ecohouse/monitor-wizard-hardware/README.md

# monitor-wizard-hardware
Schematic and board layout for the Monitor Wizard hardware.
