ecohouse/monitor-wizard-hardware/MonitorWizard-Logger.brd

## EAGLE design MonitorWizard-Logger.brd (2015-12-05)

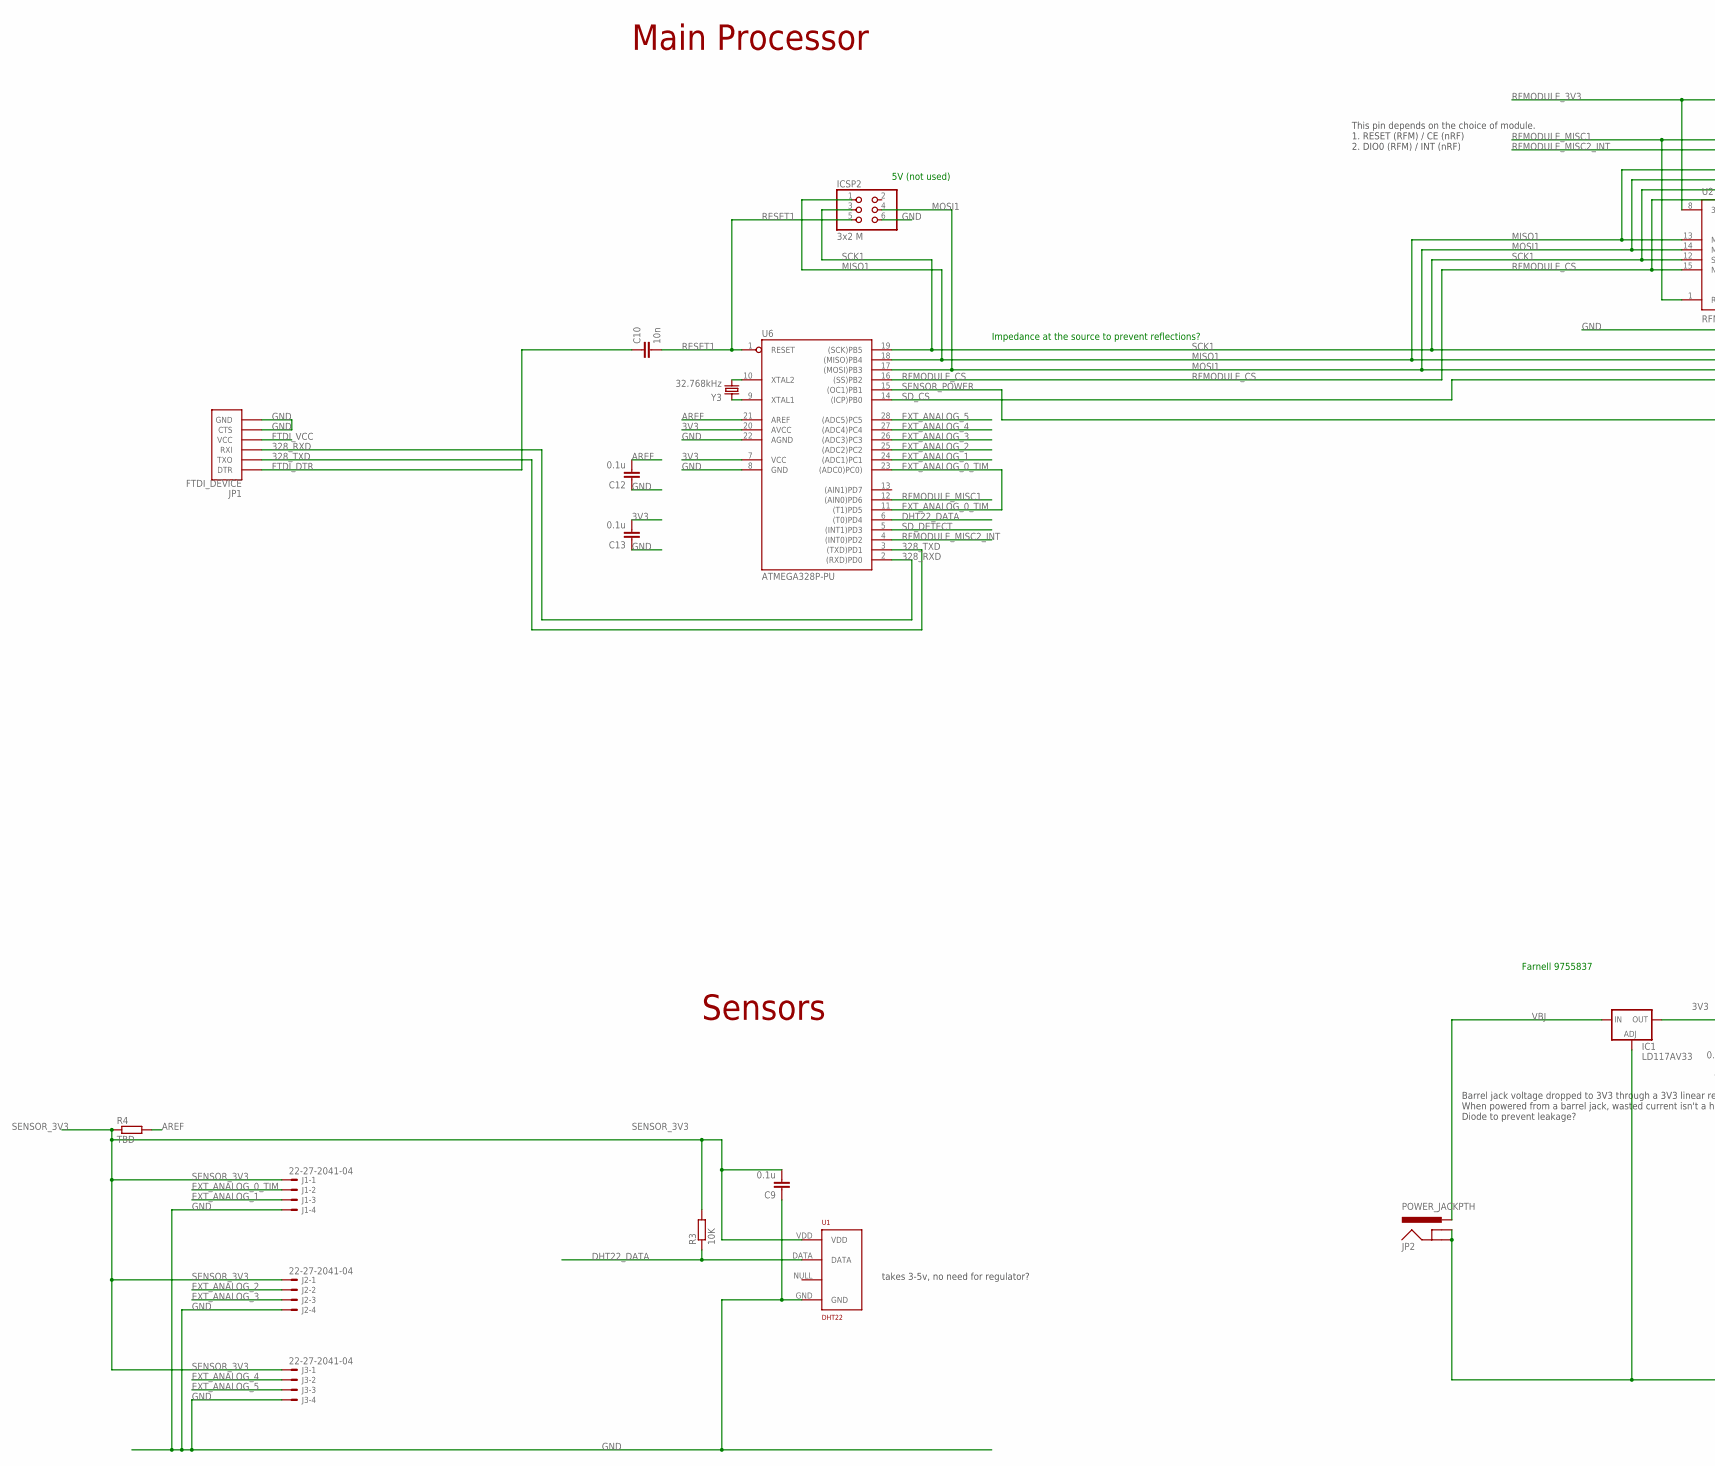
[picture p1: schematic MonitorWizard-Logger.sch, part in row 1, column 1]

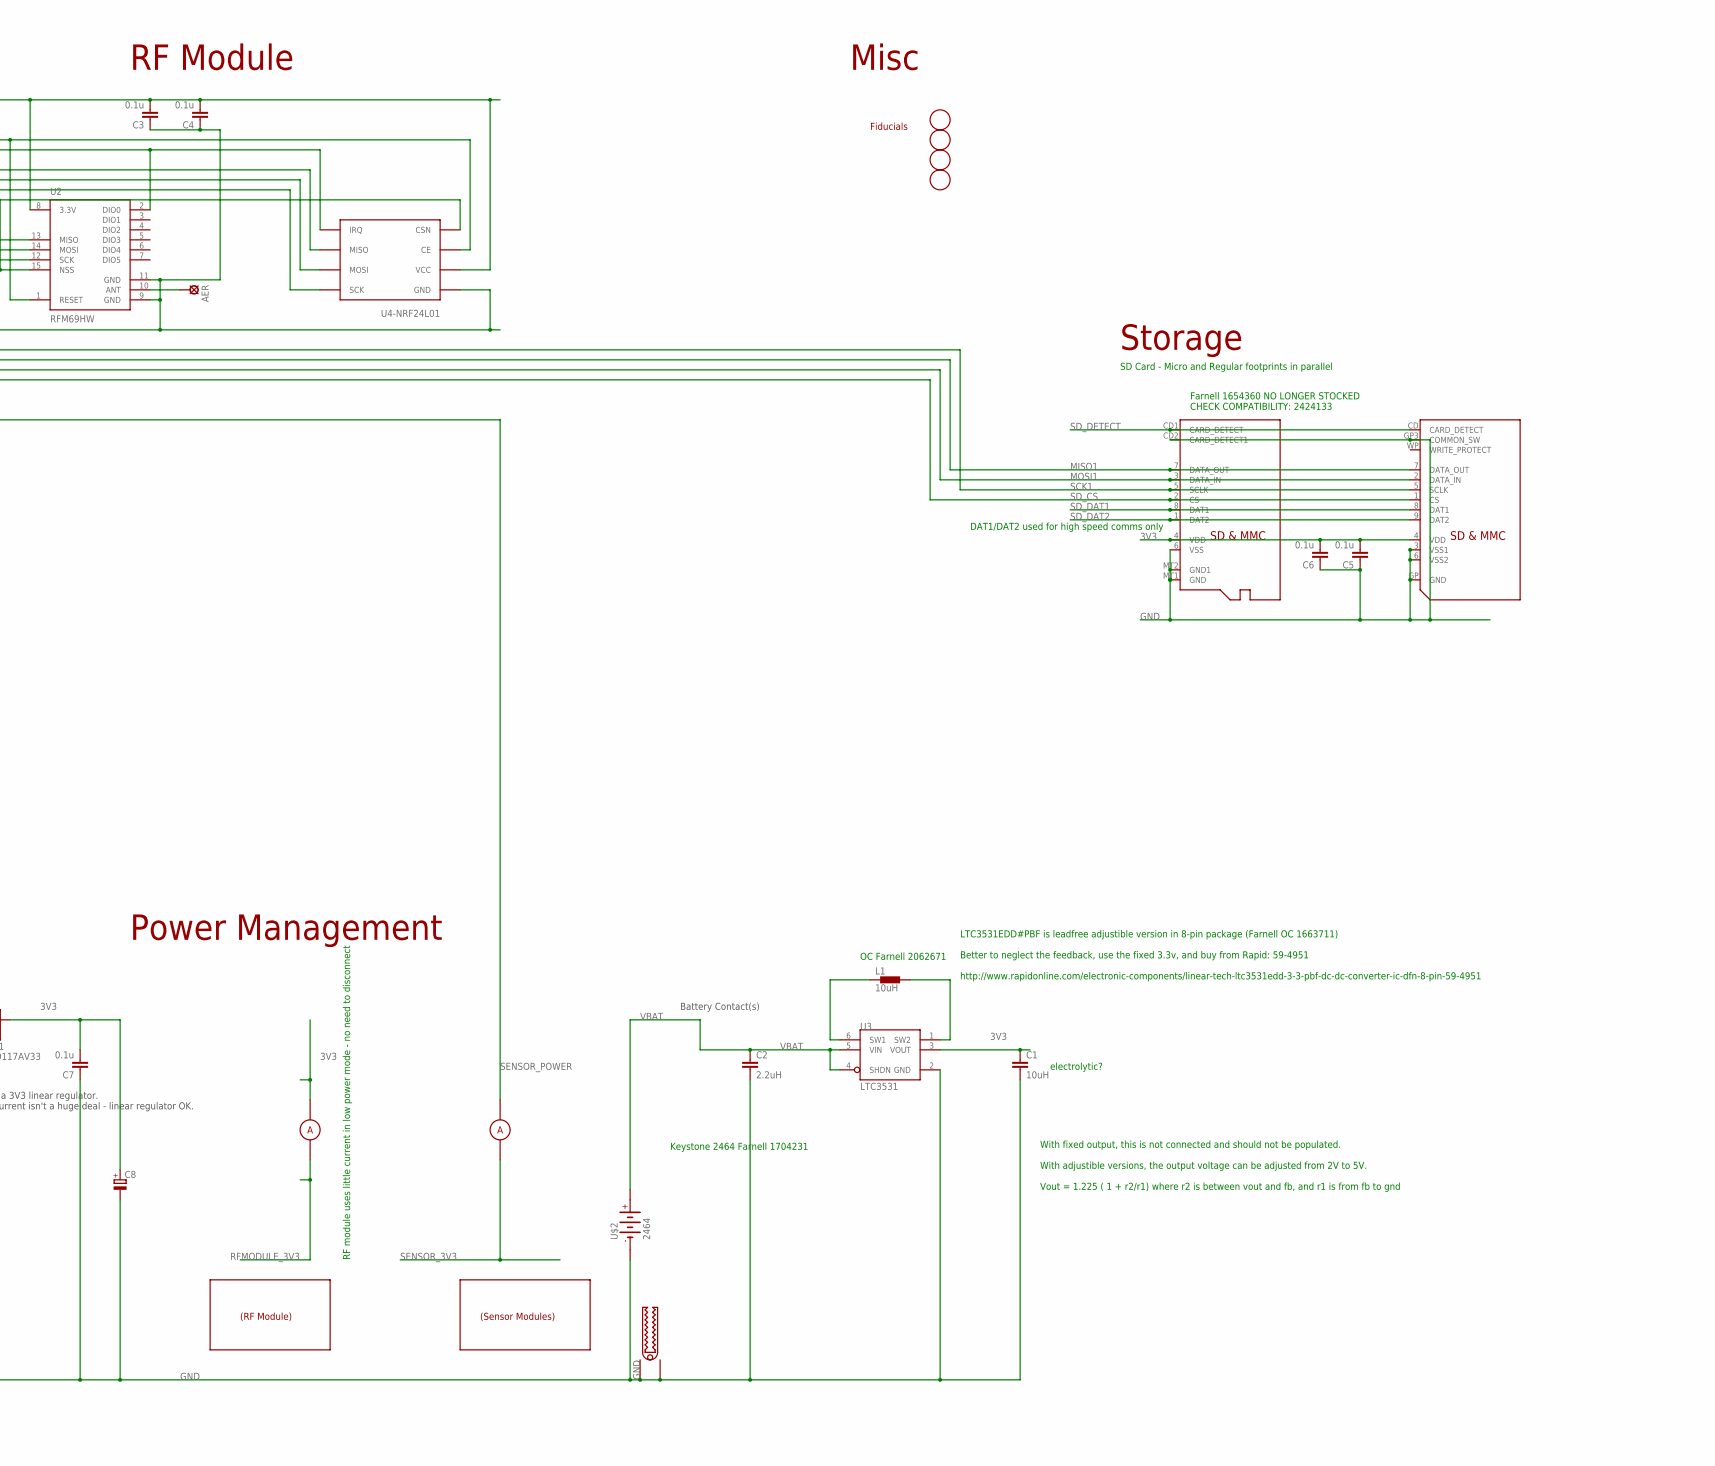
[picture p2: schematic MonitorWizard-Logger.sch, part in row 1, column 2]

Parts:
AER: LSP10
C1: 10uH; C025-024X044
C2: 2.2uH; C025-024X044
C3, C4, C5, C6, C7, C9, C12, C13: 0.1u; C025-024X044
C8: CPOL-EUE2.5-6; E2,5-6
C10: 10n; C025-024X044
CON1: MICROSD
FD1, FD2, FD3, FD4: FIDUCIALMOUNT; FIDUCIA-MOUNT
GND: ALLIGATOR
IC1: LD117AV33; TO220L1
ICSP2: 3x2 M; 2X03
I_RF: CURRENT_MEASURE_0.4A; CURRENT_MEASURE
I_SENSE: CURRENT_MEASURE_0.4A; CURRENT_MEASURE
J1, J2, J3: 22-27-2041-04; 6410-04
JP1: FTDI_DEVICE; FTDI_DEVICE_SIDE
JP2: POWER_JACKPTH; POWER_JACK_PTH
L1: 10uH; L-RADIAL-2-5OD
R3: 10K; 0207/10
R4: TBD; 0207/10
U1: DHT22; RHT03_DHT-22
U2: RFM69HW; RFM69W-XXXS2
U3: LTC3531; TSOT23-6
U4-NRF24L01: NRF24L01+-PCB-AERIAL; NRF24L01-PCB-AERIAL
U6: ATMEGA328P-PU; DIL28-3
U$1: SDMMC06132; 06132
U$2: 2464
Y3: 32.768kHz; TC26HEZ

Connections:
3V3: C1.1, C5.2, C6.2, C7.2, C8.+, C13.2, CON1.4 (VDD), IC1.2 (OUT), I_RF.P$1, U3.3 (VOUT), U6.7 (VCC), U6.20 (AVCC), U$1.4 (VDD)
328_RXD: JP1.P$3 (RXI), U6.2 ((RXD)PD0)
328_TXD: JP1.P$2 (TXO), U6.3 ((TXD)PD1)
AREF: C12.2, R4.2, U6.21 (AREF)
DHT22_DATA: R3.1, U1.DATA, U6.6 ((T0)PD4)
EXT_ANALOG_0_TIM: J1.2, U6.11 ((T1)PD5), U6.23 ((ADC0)PC0))
EXT_ANALOG_1: J1.3, U6.24 ((ADC1)PC1)
EXT_ANALOG_2: J2.2, U6.25 ((ADC2)PC2)
EXT_ANALOG_3: J2.3, U6.26 ((ADC3)PC3)
EXT_ANALOG_4: J3.2, U6.27 ((ADC4)PC4)
EXT_ANALOG_5: J3.3, U6.28 ((ADC5)PC5)
FTDI_DTR: C10.1, JP1.P$1 (DTR)
FTDI_VCC: JP1.P$4 (VCC)
GND: C1.2, C2.2, C3.1, C4.1, C5.1, C6.1, C7.1, C8.-, C9.1, C12.1, C13.1, CON1.6 (VSS), CON1.CD2 (CARD_DETECT1), CON1.MT1 (GND), CON1.MT2 (GND1), GND.BTM, GND.TOP, IC1.1 (ADJ), ICSP2.6, J1.4, J2.4, J3.4, JP1.P$5 (CTS), JP1.P$6 (GND), JP2.GND, JP2.GNDBREAK, U1.GND, U2.9 (GND), U2.11 (GND), U3.2 (GND), U4-NRF24L01.P$1 (GND), U6.8 (GND), U6.22 (AGND), U$1.3 (VSS1), U$1.6 (VSS2), U$1.GP (GND), U$1.GP3 (COMMON_SW), U$2.-
MISO1: CON1.7 (DATA_OUT), ICSP2.1, U2.13 (MISO), U4-NRF24L01.P$7 (MISO), U6.18 ((MISO)PB4), U$1.7 (DATA_OUT)
MOSI1: CON1.3 (DATA_IN), ICSP2.4, U2.14 (MOSI), U4-NRF24L01.P$6 (MOSI), U6.17 ((MOSI)PB3), U$1.2 (DATA_IN)
unnamed: L1.P$2 (2), U3.1 (SW2)
unnamed: L1.P$1 (1), U3.6 (SW1)
unnamed: AER.MP, U2.10 (ANT)
RESET1: C10.2, ICSP2.5, U6.1 (RESET)
RFMODULE_3V3: C3.2, C4.2, I_RF.P$2, U2.8 (3.3V), U4-NRF24L01.P$2 (VCC)
RFMODULE_CS: U2.15 (NSS), U4-NRF24L01.P$4 (CSN), U6.16 ((SS)PB2)
RFMODULE_MISC1: U2.1 (RESET), U4-NRF24L01.P$3 (CE), U6.12 ((AIN0)PD6)
RFMODULE_MISC2_INT: U2.2 (DIO0), U4-NRF24L01.P$8 (IRQ), U6.4 ((INT0)PD2)
SCK1: CON1.5 (SCLK), ICSP2.3, U2.12 (SCK), U4-NRF24L01.P$5 (SCK), U6.19 ((SCK)PB5), U$1.5 (SCLK)
SD_CS: CON1.2 (CS), U6.14 ((ICP)PB0), U$1.1 (CS)
SD_DAT1: CON1.8 (DAT1), U$1.8 (DAT1)
SD_DAT2: CON1.1 (DAT2), U$1.9 (DAT2)
SD_DETECT: CON1.CD1 (CARD_DETECT), U6.5 ((INT1)PD3), U$1.CD (CARD_DETECT)
SENSOR_3V3: C9.2, I_SENSE.P$2, J1.1, J2.1, J3.1, R3.2, R4.1, U1.VDD
SENSOR_POWER: I_SENSE.P$1, U6.15 ((OC1)PB1)
VBAT: C2.1, U3.4 (SHDN), U3.5 (VIN), U$2.+
VBJ: IC1.3 (IN), JP2.PWR
XTAL_N: U6.9 (XTAL1), Y3.2
XTAL_P: U6.10 (XTAL2), Y3.1

Notes on the sheet:
RF Module
Main Processor
Sensors
Power Management
This pin depends on the choice of module. 1. RESET (RFM) / CE (nRF) 2. DIO0 (RFM) / INT (nRF)
Barrel jack voltage dropped to 3V3 through a 3V3 linear regulator. When powered from a barrel jack, wasted current isn't a huge deal - linear regulator OK. Diode to prevent leakage?
Misc
(RF Module)
(Sensor Modules)
Battery Contact(s)
Fiducials
takes 3-5v, no need for regulator?
LTC3531EDD#PBF is leadfree adjustible version in 8-pin package (Farnell OC 1663711) Better to neglect the feedback, use the fixed 3.3v, and buy from Rapid: 59-4951 http://www.rapidonline.com/electronic-components/linear-tech-ltc3531edd-3-3-pbf-dc-dc-converter-ic-dfn-8-pin-59-4951
With fixed output, this is not connected and should not be populated. With adjustible versions, the output voltage can be adjusted from 2V to 5V. Vout = 1.225 ( 1 + r2/r1) where r2 is between vout and fb, and r1 is from fb to gnd
OC Farnell 2062671
electrolytic?
Farnell 9755837
SD Card - Micro and Regular footprints in parallel
Storage
Farnell 1654360 NO LONGER STOCKED CHECK COMPATIBILITY: 2424133
Keystone 2464 Farnell 1704231
RF module uses little current in low power mode - no need to disconnect
DAT1/DAT2 used for high speed comms only
5V (not used)
Impedance at the source to prevent reflections?

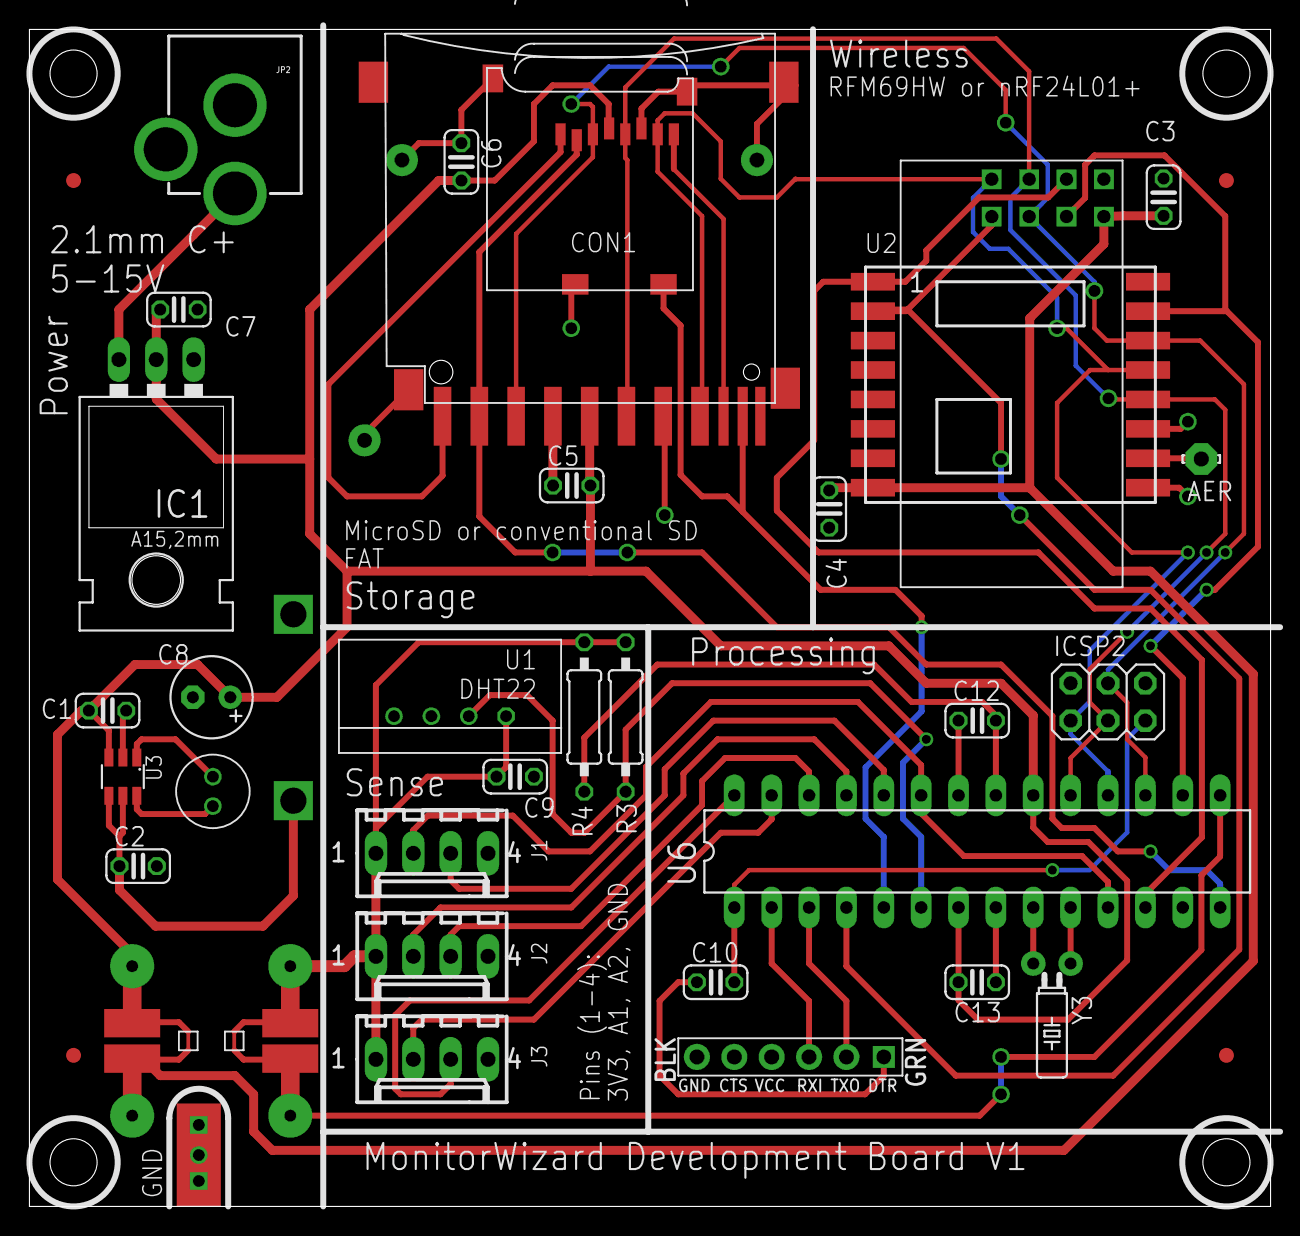
[picture p3: board MonitorWizard-Logger.brd from above]

Board: 2 copper layers, 84.4 x 80.0 mm, 39 parts (1 on the bottom side), 34 nets.
