ecohouse/monitor-wizard-hardware/(commit log)

2015-04-18 Initial commit - not yet complete, but overall design is basically correct.
    [MonitorWizard-Logger.brd, MonitorWizard-Logger.sch]
2015-04-18 Switch to PNP transistors, connect data lines to chip.
    [MonitorWizard-Logger.brd, MonitorWizard-Logger.sch]
2015-04-19 Remove redundant components, play with board layout.
    [MonitorWizard-Logger.brd, MonitorWizard-Logger.sch]
2015-04-30 Add DHT22 library, tweak board layout. Still unfinished.
    [MonitorWizard-Logger.brd, MonitorWizard-Logger.sch]
2015-05-14 Replace power supply with low power switching setup. Remove resistors for level shifting, since everything will now be running at 3.3v.
    [MonitorWizard-Logger.brd, MonitorWizard-Logger.sch]
2015-06-11 Add SD card, battery box. Nearly finished - just have to connect SD and lay out.
    [MonitorWizard-Logger.brd, MonitorWizard-Logger.sch]
2015-06-14 Hopefully completed the schematic.
    [MonitorWizard-Logger.brd, MonitorWizard-Logger.sch]
2015-06-14 Fiddle with layout slightly.
    [MonitorWizard-Logger.brd]
2015-06-14 Update battery box footprint.
    [MonitorWizard-Logger.brd, MonitorWizard-Logger.sch]
2015-06-16 Add decoupling capacitors, begin to route board.
    [MonitorWizard-Logger.brd, MonitorWizard-Logger.sch]
2015-06-19 Route most of layout - just have to route (and terminate?) the SPI bus now.
    [MonitorWizard-Logger.brd]
2015-07-01 Route remaining wires. Still needs the following: Confirm SD card current draw (idle, writing) - is a FET required to power the SD card down? Impedance matching SPI lines / SPI routing improvements? 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
    [MonitorWizard-Logger.brd, MonitorWizard-Logger.sch]
2015-07-01 Fix some DRC errors, tidy silkscreen, improve grounding.
    [MonitorWizard-Logger.brd, MonitorWizard-Logger.sch]
2015-07-01 More silkscreen fixes, move power jack to make more room for screw, tweak spacing of sensor connectors.
    [MonitorWizard-Logger.brd, MonitorWizard-Logger.sch]
2015-07-01 Add electrolytic filter capacitor.
    [MonitorWizard-Logger.brd, MonitorWizard-Logger.sch]
2015-10-12 Make the board smaller by pushing battery box to rear
    [MonitorWizard-Logger.brd, MonitorWizard-Logger.sch]
2015-10-19 Shrink board, move barrel jack out of way of screw head
    [MonitorWizard-Logger.brd]
2015-10-23 Change to a better barrel jack footprint
    [MonitorWizard-Logger.brd, MonitorWizard-Logger.sch]
2015-11-30 Change footprint for LTC3531
    [MonitorWizard-Logger.brd, MonitorWizard-Logger.sch]
2015-12-05 Move some stuff around, add a filter capacitor. As ordered from Screenbond
    [MonitorWizard-Logger.brd, MonitorWizard-Logger.sch]
